superfansizhe-beep/tscircuit-stm32f302-board/circuits/stm32f302/REQUIREMENTS.md

# 需求清单 — STM32F302R8T6 考核板

> 来源：`~/Downloads/1(1).docx`（21 段，无图片、无隐藏内容，已逐字核对）
> 硬截止：**2026-10-13 18:00**　提交邮箱：`sorenlin21@gmail.com`
> 本文只讲"要做什么"，不讲"怎么做"。选型与实现见后续文档。

---

## 0. 题目原文（逐条转录）

```
1. 实现电压转换 12V 转 5V 转 3.3V（带电源指示灯）。
   12V 转 5V 使用 RY8411，5V 转 3.3V 使用 TLV75733PDBVR。
   要有开关方便测试，电源接口为 XT30。
2. 实现 STM32F302R8T6 最小系统，包括 8MHz 外部晶振、RESET 按键、BOOT 按键及 SWD
   下载调试接口等（可以不用低速晶振）。
3. 实现三路 UART，均使用 PH2.0 接口引出，包含 3.3V、GND、TX、RX。
4. 实现三路 I2C。一路连接 AT24C64D EEPROM，一路连接 TMP1075 温度传感器，一路使用
   PH2.0 接口引出。
5. 实现两路 SPI。一路连接 MCP23S17，扩展 16 路 GPIO，并使用 2×8、2.54mm 排针引出；
   另一路使用 PH2.0 1×6P 接口引出。
6. 实现一路 CAN 通信，使用 TCAN332 CAN 收发器，接口引出 CANH、CANL，使用 PH2.0
   接口引出。
7. 实现六路 PWM 输出，使用 3个1×6 排针，三排分别为 PWM、5V、GND
   （建议搜搜看pwm排针是怎么摆放的）
8. 实现三路 ADC 电压采样，分别采集 12V、5V、3.3V 电源电压。
9. 实现三路 GPIO 驱动 LED 指示灯。
10. 所有贴片电阻、电容统一采用 0603 或 0805封装，8MHz 晶振采用 3225 封装。
11. PCB 尺寸不超过 80mm×80mm，层数不超过 4 层。
```

> ⚠️ 第 7 条原文是「3个**1×6** 排针」。旧交接文档里写的「1×16」与原文不符，**以原文为准**。

---

## 1. 交付物与评分

### 交付物

| # | 交付物 | 形式 |
|---|---|---|
| D1 | 原理图截图 | 图片 |
| D2 | PCB 正面截图 | 图片 |
| D3 | PCB 反面截图 | 图片 |
| D4 | `.epro2` 工程文件 | 嘉立创 EDA 专业版格式 |

全部发到 `sorenlin21@gmail.com`。截止 **10-13 18:00**。

### 评分权重

| 项 | 占比 | 细分 |
|----|---|---|
| **原理图** | **60%** | 元件 40% + 电源 30% + 标注 20% + 布局 10% |
| **PCB** | **40%** | 布局 70% + 布线 30% |

> 出题人原话：「请优先保证！！原理图准确！！再开始布局PCB（会保证原理图质量，
> 我看到原理图错太多心情会不好）」
> **→ 施工顺序必须是：原理图做对做干净 → 才开始 PCB。**

### 红线

| 红线 | 后果 |
|---|---|
| **禁止使用嘉立创自动布线** | **0 分** |
| 禁止问学长学姐（除题目阅读理解外） | — |
| 可以适当使用 AI 工具 | 允许 |

---

## 2. 显式要求清单

### R1 — 电源转换（要求 1）

| # | 要求 | 备注 |
|---|---|---|
| R1.1 | 12V → 5V，**必须**用 RY8411 | 型号指定，不可换 |
| R1.2 | 5V → 3.3V，**必须**用 TLV75733PDBVR | 型号指定，不可换 |
| R1.3 | 带电源指示灯 | ⚠️ 数量未指定，见 §4-Q2 |
| R1.4 | 要有开关，方便测试 | ⚠️ 总开关还是分路，见 §4-Q3 |
| R1.5 | 电源接口为 XT30 | 公/母头未指定 |

### R2 — MCU 最小系统（要求 2）

| # | 要求 | 备注 |
|---|---|---|
| R2.1 | 主控 STM32F302R8T6 | ⚠️ 原厂无货，见 §4-Q1 |
| R2.2 | 8MHz 外部晶振（HSE） | 封装强制 3225（R10.3） |
| R2.3 | RESET 按键 | |
| R2.4 | BOOT 按键 | 即 BOOT0 选择 |
| R2.5 | SWD 下载调试接口 | ⚠️ 排针规格未指定，见 §4-Q5 |
| R2.6 | 「**等**」= 隐含必需项 | 见下方推导 |
| R2.7 | 可以不用低速晶振（LSE） | 即 32.768kHz 可不装 |

**R2.6「等」的推导**（最小系统跑起来所必需，题目没写但不能漏）：

- 全部 VDD / VSS 引脚 + 每对一颗 100nF 去耦
- VDDA / VSSA 滤波（1µF + 10nF）
- VREF+ 处理
- VCAP（若该型号有）接电容
- VBAT 处理
- BOOT0 下拉电阻（否则不能稳定从 Flash 启动）
- NRST 上拉 + 滤波电容
- 晶振负载电容（按晶振规格）
- 各路电源的储能/大容量电容

### R3 — 三路 UART（要求 3）

| # | 要求 |
|---|---|
| R3.1 | 共 **3** 路 |
| R3.2 | 每路用 **PH2.0** 接口引出 |
| R3.3 | 每路 **4 线**：3.3V、GND、TX、RX |

### R4 — 三路 I2C（要求 4）

| # | 要求 | 连接对象 |
|---|---|---|
| R4.1 | 第 1 路 | **AT24C64D** EEPROM |
| R4.2 | 第 2 路 | **TMP1075** 温度传感器 |
| R4.3 | 第 3 路 | **PH2.0** 接口引出 |

- 隐含：I2C 需要上拉电阻（阻值按总线速率与容性负载定）
- ⚠️ 硬件 I2C 资源可能不足 3 路，见 §4-Q4

### R5 — 两路 SPI（要求 5）

| # | 要求 | 细节 |
|---|---|---|
| R5.1 | SPI-A → **MCP23S17** | 扩展 **16 路 GPIO**，用 **2×8、2.54mm 排针**引出 |
| R5.2 | SPI-B | 用 **PH2.0 1×6P** 接口引出 |

- 隐含：MCP23S17 是 SPI 接口的 16 位 IO 扩展器，需要 CS、地址脚 A0/A1/A2、
  RESET、INT 的处理；2×8 = 16 脚正好对应 16 路 GPIO

### R6 — 一路 CAN（要求 6）

| # | 要求 |
|---|---|
| R6.1 | 使用 **TCAN332** CAN 收发器 |
| R6.2 | 接口引出 **CANH、CANL** |
| R6.3 | 使用 **PH2.0** 接口引出 |

- ⚠️ 终端电阻（120Ω）题目未提，见 §4-Q6

### R7 — 六路 PWM（要求 7）

| # | 要求 |
|---|---|
| R7.1 | 共 **6** 路 PWM 输出 |
| R7.2 | 使用 **3 个 1×6 排针** |
| R7.3 | 「三排分别为 PWM、5V、GND」 |

> ⚠️ **R7.3 是本清单歧义最大的一条**，出题人还专门提示「建议搜搜看pwm排针是怎么摆放的」，
> 说明他心里有一个标准摆法。两种读法见 §4-Q7，**开工前必须定死**。

### R8 — 三路 ADC 采样（要求 8）

| # | 要求 |
|---|---|
| R8.1 | 采集 **12V** 电源电压 |
| R8.2 | 采集 **5V** 电源电压 |
| R8.3 | 采集 **3.3V** 电源电压 |

- 隐含：12V/5V 超出 ADC 量程（3.3V），必须分压；分压比与功耗需权衡

### R9 — 三路 GPIO LED（要求 9）

| # | 要求 |
|---|---|
| R9.1 | **3** 路 GPIO |
| R9.2 | 驱动 **LED 指示灯** |

- 隐含：每路需限流电阻；LED 接法（灌电流/拉电流）影响固件极性

### R10 — 封装规范（要求 10）

| # | 要求 |
|---|---|
| R10.1 | **所有**贴片电阻统一 0603 或 0805 |
| R10.2 | **所有**贴片电容统一 0603 或 0805 |
| R10.3 | 8MHz 晶振采用 **3225** 封装 |

### R11 — 板子约束（要求 11）

| # | 要求 |
|---|---|
| R11.1 | PCB 尺寸 **≤ 80mm × 80mm** |
| R11.2 | 层数 **≤ 4 层** |

---

## 3. 模块划分

一个子电路一个文件，最后在 `main.tsx` 里拼装。

| 模块 | 文件 | 覆盖要求 | 主要器件 |
|---|---|---|---|
| **M1 电源** | `modules/01-power.tsx` | R1 | XT30、开关、RY8411、TLV75733PDBVR、电源指示灯、储能/去耦 |
| **M2 MCU 最小系统** | `modules/02-mcu.tsx` | R2 | STM32F302R8T6、8MHz 3225、RESET/BOOT 按键、SWD、全套去耦 |
| **M3 UART ×3** | `modules/03-uart.tsx` | R3 | 3× PH2.0 1×4 |
| **M4 I2C ×3** | `modules/04-i2c.tsx` | R4 | AT24C64D、TMP1075、PH2.0 1×4、上拉电阻 |
| **M5 SPI ×2** | `modules/05-spi.tsx` | R5 | MCP23S17、2×8 排针、PH2.0 1×6 |
| **M6 CAN** | `modules/06-can.tsx` | R6 | TCAN332、PH2.0、（终端电阻？） |
| **M7 PWM ×6** | `modules/07-pwm.tsx` | R7 | 3× 1×6 排针 |
| **M8 ADC 采样** | `modules/08-adc.tsx` | R8 | 分压电阻网络 ×3 |
| **M9 GPIO LED** | `modules/09-led.tsx` | R9 | LED ×3 + 限流电阻 ×3 |
| **M0 顶层拼装** | `main.tsx` | R10, R11, 全局 | 板框、丝印、电源网络分配 |

### 横切关注点（不属于任何单个模块）

- **电源网络分配**：`net.VIN_12V` / `net.+5V` / `net.+3V3` / `net.GND` 的统一定义与跨模块复用
- **全局去耦**：每个 IC 的电源脚就近去耦（在各自模块内实现，但需全局清点，防止漏接）
- **测试点**：ADC 与各路电源是否加测试点
- **丝印**：接口定义标注（PH2.0 各脚是什么、排针各脚是什么）

---

## 4. 决策记录（已全部拍板）

> 总原则（用户原话）：**「不用达到最完美答案，只要不错能过就行。」**
> 因此下列决策一律选「**不会因为选错而被扣分**」的那个，而不是「最优」的那个。

| # | 问题 | **决策** | 依据 |
|---|---|---|---|
| **Q1** | STM32F302R8T6 无货 | **照题面画 STM32F302R8T6（LQFP-64）**，不管现实库存 | 用户指示：「照着题面画，不用管现实问题」。题目钉死型号，改型号反而是错 |
| **Q2** | 电源指示灯几颗 | **3 颗**：12V、5V、3.3V 各一颗 | 「带电源指示灯」未指定数量；每路一颗可覆盖全部解读，**不会因为少装被判漏** |
| **Q3** | 开关形式 | **12V 输入总开关**（SPDT 拨动开关） | 「要有开关方便测试」——总开关是最直接、最不会被挑刺的实现 |
| **Q4** | 硬件 I2C 够不够 3 路 | ✅ **已查明：够。有 I2C1 / I2C2 / I2C3 三路硬件 I2C** | ST 官方 CMSIS 头 `stm32f302x8.h`（见 §4.1）。**不需要软件模拟** |
| **Q5** | SWD 接口规格 | **2×5、2.54mm 排针**（ARM 标准 10 脚） | 最通用、最好焊、评审一眼认得 |
| **Q6** | CAN 终端电阻 | **板载 120Ω 一颗** | CAN 总线的标准要求，装了是正确，不装才是缺陷 |
| **Q7** | PWM 排针摆法 | **三排平行紧贴的「舵机轨」**（见 §4.2） | 同时满足题面字面要求 + 题面提示的行业惯例 |
| **Q8** | ADC 分压比 | 12V/5V 分压到 ADC 满量程**留余量** | 避免超量程；「不错即可」 |
| **Q9** | 是否装 LSE | **不装** | 题目明说「可以不用低速晶振」 |
| **Q10** | 板层数 | **2 层** | 上限是 4 层，2 层已足够且**更容易被评审看懂**；布线也更容易做干净 |

### 4.1 Q4 的证据（一手权威源）

ST 官方 CMSIS 设备头文件 `stm32f302x8.h`（覆盖 STM32F302R8T6）中定义的完整外设清单：

```
I2C1_BASE  I2C2_BASE  I2C3_BASE          ← 三路硬件 I2C，正好满足要求 4
SPI2_BASE  SPI3_BASE                     ← 两路 SPI（注意：没有 SPI1）
USART1_BASE USART2_BASE USART3_BASE      ← 三路 UART，正好满足要求 3
ADC1_BASE                                ← 只有 ADC1（多通道）
CAN_BASE
TIM1 TIM2 TIM6 TIM15 TIM16 TIM17         ← 无 TIM3 / TIM4
GPIOA GPIOB GPIOC GPIOD GPIOF            ← 注意：没有 GPIOE
```

**来源**：`https://raw.githubusercontent.com/STMicroelectronics/cmsis-device-f3/master/Include/stm32f302x8.h`
（st.com 本站直连与代理均被 WAF 拦，HTTP 567；GitHub 上的 ST 官方仓库可达。）

**对本设计的三个直接影响**：

1. 要求 4 的三路 I2C → 直接用 I2C1/I2C2/I2C3，**无需求助软件模拟**。
2. 要求 5 的两路 SPI → 只能落在 **SPI2 与 SPI3**（该型号没有 SPI1），引脚分配时不要去找 SPI1。
3. 要求 7 的六路 PWM → 可用通道富裕：TIM1(4) + TIM2(4) + TIM15(2) + TIM16(1) + TIM17(1)。

### 4.2 Q7 的答案：三排平行紧贴的「舵机轨」

**做法**：3 个 1×6 排针**平行、紧贴、行距 2.54mm** 摆放：

```
        列1    列2    列3    列4    列5    列6
第1排   PWM1   PWM2   PWM3   PWM4   PWM5   PWM6     ← 整排都是 PWM 信号
第2排   +5V    +5V    +5V    +5V    +5V    +5V      ← 整排都是 5V
第3排   GND    GND    GND    GND    GND    GND      ← 整排都是 GND
```

**为什么这个答案是「能过」的**：

| 判据 | 是否满足 |
|---|---|
| 「使用 **3个1×6 排针**」 | ✅ 字面满足：确实是三个独立的 1×6 排针 |
| 「**三排分别为 PWM、5V、GND**」 | ✅ 字面满足：第 1 排全是 PWM、第 2 排全是 5V、第 3 排全是 GND |
| 题面提示「建议搜搜看 pwm 排针是怎么摆放的」 | ✅ 每**列**（跨三排）正好构成一个标准 3 脚舵机/PWM 接口，脚序 **信号 → 电源 → 地**，与题面给出的顺序一字不差。这是行业惯例摆法 |

**关键点**：这个解法让「按信号分排」（字面）和「按通道分组」（惯例）**同时成立** ——
三排各自是同一种信号（满足字面），而竖着看每一列就是一个完整通道（满足惯例）。
不需要在两者之间二选一。

**来源参考**：舵机标准 3 线定义为 信号 / 电源 / 地
（[01Studio 舵机文档](https://wiki.01studio.cc/docs/canmv_k230/sensor_module/servo/)、
[Waveshare Servo Driver HAT 手册](https://www.waveshare.net/w/upload/e/e3/Servo_Driver_HAT_User_Manual_CN.pdf)、
[NXP HoverGames Servorail](https://nxp.gitbook.io/hovergames/rddrone-fmuk66/connectors/servorail)）。

---

### 4.3 原始待澄清项（存档，供追溯）

按「不解决就会做错」的严重性排序。

| # | 问题 | 影响 | 备选 |
|---|---|---|---|
| **Q1** | **STM32F302R8T6 全系无货**（C504601 及 R8T6TR 库存均为 0） | 物料不可得 | 换 **STM32F302RCT6**（同 LQFP-64 封装、引脚兼容、Flash 更大、库存 4427）。若严格按题面型号，则只能按 R8T6 画板、物料自备 |
| **Q2** | **R1.3「带电源指示灯」几颗？** | 元件数与丝印 | (a) 一颗总电源灯　(b) 12V/5V/3.3V 各一颗　(c) 5V/3.3V 各一颗 |
| **Q3** | **R1.4「开关方便测试」是哪种开关？** | 电路拓扑 | (a) 12V 输入总开关　(b) 每路输出一个测试开关　(c) 总开关 + 跳线帽 |
| **Q4** | **STM32F302R8T6 硬件 I2C 是否够 3 路？** | 引脚分配 | 若只有 I2C1/I2C2，第 3 路需 GPIO 软件模拟。正在核实 |
| **Q5** | **SWD 接口规格？** | 连接器选型 | (a) 2×5 1.27mm（ARM 标准）　(b) 2×5 2.54mm　(c) 1×4 2.54mm |
| **Q6** | **CAN 要不要板载 120Ω 终端电阻？** | 电路正确性 | (a) 固定焊一颗　(b) 跳线/焊接跳线可选　(c) 不装 |
| **Q7** | **R7「三排分别为 PWM、5V、GND」到底怎么摆？** | 排针定义 | 见下方专项分析 |
| **Q8** | **ADC 分压比与输入阻抗？** | 采样精度 | 12V 分压比需保证 3.3V 满量程留余量 |
| **Q9** | **是否需要 LSE（32.768kHz）？** | 元件数 | 题目明说「可以不用」→ 建议不装 |
| **Q10** | **PCB 层数用 2 层还是 4 层？** | 布线难度 | 题目上限 4 层；2 层更易手工/评审，4 层更好布线 |

### Q7 专项分析（PWM 排针摆法）

题面「3个1×6 排针，三排分别为 PWM、5V、GND」，两种读法：

- **读法 A —— 按信号分排**：3 个排针，一个全是 6 路 PWM 信号、一个全是 6 个 5V、一个全是 6 个 GND。
  用杜邦线跨接使用。
- **读法 B —— 按通道分组**：每个 1×6 排针装 2 路完整通道，脚序 `PWM,5V,GND,PWM,5V,GND`。
  3 个排针 = 6 路。这是舵机/风扇类接口的常见摆法，也给每路就地供电与地回路。

题面特意提示「建议搜搜看pwm排针是怎么摆放的」，出题人大概率指的是**读法 B**
（这是行业里 PWM 排针的惯用摆法），但需要调研确认，必要时向出题人提问（题目允许问阅读理解问题）。

---

## 5. 硬约束速查（不可违背）

| 约束 | 内容 |
|---|---|
| 型号钉死 | RY8411、TLV75733PDBVR、STM32F302R8T6、AT24C64D、TMP1075、MCP23S17、TCAN332 |
| 封装钉死 | 贴片阻容 0603 或 0805；8MHz 晶振 3225 |
| 接口钉死 | XT30 电源；UART/I2C/CAN 用 PH2.0；SPI-A 用 2×8 2.54mm 排针；SPI-B 用 PH2.0 1×6P；PWM 用 3× 1×6 排针 |
| 板子钉死 | ≤80×80mm，≤4 层 |
| 流程钉死 | 先原理图后 PCB；禁止嘉立创自动布线 |
| 时间钉死 | 10-13 18:00 |
