superfansizhe-beep/tscircuit-stm32f302-board/circuits/stm32f302/REFDES.md

# 位号分配表 — 全板唯一

**为什么必须提前定**：位号（R1 / C1 / U1 …）在整块板上必须**全局唯一**。
如果每个模块各自从 R1 开始编，9 个模块会撞出 9 个 R1 —— 而 tscircuit **不会报错**，
只会生成一堆重名元件，PCB 丝印、BOM、装配图全乱。这是必须在放器件之前钉死的。

---

## 分配总表

| 模块 | 页 | 电阻 | 电容 | 其它元件 |
|---|----|---|---|---|
| **01 电源** | 电源 | `R1–R9` | `C1–C9` | `U1` `U2` `L1` `SW1` `J1` `D1–D3` |
| **02 最小系统** | 最小系统 | `R10–R19` | `C10–C29` | `U3` `Y1` `SW2` `SW3` `J11` |
| **03 串口** | UART | — | — | `J2` `J3` `J4` |
| **04 I2C** | I2C | `R20–R25` | `C30–C31` | `U4` `U5` `J5` |
| **05 SPI** | SPI | `R26–R27` | `C32–C33` | `U6` `J6` `J12` |
| **06 CAN** | CAN | `R28–R29` | `C34` | `U7` `J7` |
| **07 PWM** | PWM | — | — | `J8` `J9` `J10` |
| **08 ADC 采样** | ADC 采样 | `R30–R35` | `C35–C37` | — |
| **09 指示灯** | 指示灯 | `R36–R38` | — | `LED1–LED3` |

**留白**：每段都留了余量。实装时若超出，**顺延到下一个未被占用的号**，
不要插进别的模块的段里（那会破坏"按模块可读"的好处）。

---

## 命名约定

| 前缀 | 含义 | 示例 |
|---|---|---|
| `U` | 集成电路 | `U1` RY8411 |
| `R` | 电阻 | `R1` 100k |
| `C` | 电容 | `C1` 22µF |
| `L` | 电感 | `L1` 4.7µH |
| `D` | **电源指示灯**（电源页） | `D1` 12V 红 |
| `LED` | **GPIO 指示灯**（指示灯页） | `LED1` PC6 绿 |
| `Y` | 晶振 | `Y1` 8MHz |
| `FB` | 磁珠 | `FB1` VDDA 隔离 |
| `SW` | 开关 / 按键 | `SW1` 拨动开关、`SW2` RESET |
| `J` | 连接器 / 排针 | `J1` XT30、`J11` SWD |

> ⚠️ **`D` 与 `LED` 是两套不同的东西**，不要混：
> `D1–D3` 是电源页的三颗电源指示灯（12V / 5V / 3.3V）；
> `LED1–LED3` 是要求 9 的三颗 GPIO 驱动指示灯。
> 分开命名是为了让"要求 1 的指示灯"和"要求 9 的指示灯"在 BOM 和丝印上一眼可辨。

---

## 各模块详细占用

### 01 电源页

| 位号 | 器件 | 值 / 型号 | 封装 |
|---|---|---|---|
| `J1` | XT30 电源座 | XT30UPB-M | 插件 |
| `SW1` | 电源开关 | SS-12F44-G5 | 插件 SPDT |
| `U1` | 降压 IC | RY8411 | SOT-23-6 |
| `L1` | 功率电感 | 4.7µH | 4×4mm |
| `U2` | LDO | TLV75733PDBVR | SOT-23-5 |
| `C1` | 12V 输入储能 | 22µF | 0805 |
| `C2` | 12V 输入高频去耦 | 100nF | 0603 |
| `C3` | 自举电容（BS–SW） | 100nF | 0603 |
| `R4` | FB 上分压 | 100k | 0603 |
| `R5` | FB 下分压 | 19.1k | 0603 |
| `C4` | 5V 输出储能 | 22µF | 0805 |
| `C5` | 5V 输出高频 | 100nF | 0603 |
| `C6` | 3.3V 输入电容 | 1µF | 0603 |
| `C7` | 3.3V 输出电容 | 1µF | 0603 |
| `R1` | 12V 指示灯限流 | 4.7k | 0603 |
| `D1` | 12V 指示灯 | 红 | 0603 |
| `R2` | 5V 指示灯限流 | 1k | 0603 |
| `D2` | 5V 指示灯 | 绿 | 0603 |
| `R3` | 3.3V 指示灯限流 | 330Ω | 0603 |
| `D3` | 3.3V 指示灯 | 蓝 | 0603 |

### 02 最小系统页

| 位号 | 器件 | 值 / 型号 | 封装 |
|---|---|---|---|
| `U3` | 主控 | STM32F302R8T6 | LQFP-64 |
| `Y1` | HSE 晶振 | 8MHz 无源 | SMD3225-4P |
| `SW2` | RESET 按键 | TS-1187A | SMD-4P |
| `SW3` | BOOT 按键 | TS-1187A | SMD-4P |
| `J11` | SWD 调试口 | 2×5 2.54mm | 插件 |
| `FB1` | VDDA 隔离磁珠 | BLM18AG601SN1D | C19330 | 0603 |
| `C10–C13` | VDD 去耦 | 100nF ×4 | 0603 |
| `C14` | VDD 总储能 | 4.7µF | 0603 |
| `C15` | VDDA 滤波 | 1µF | 0603 |
| `C16` | VDDA 高频 | 10nF | 0603 |
| `C17` | VBAT 去耦 | 100nF | 0603 |
| `C18–C19` | 晶振负载电容 | 15pF ×2 | 0603 |
| `R10` | NRST 上拉 | 10k | 0603 |
| `C20` | NRST 滤波 | 100nF | 0603 |
| `R11` | BOOT0 下拉 | 10k | 0603 |
| `R12` | BOOT1 下拉 | 10k | 0603 |

（其余位号留白给上电时序、测试点等）
