superfansizhe-beep/tscircuit-stm32f302-board/out/stm32f302/deliverables/01-原理图/00-九页总图.png

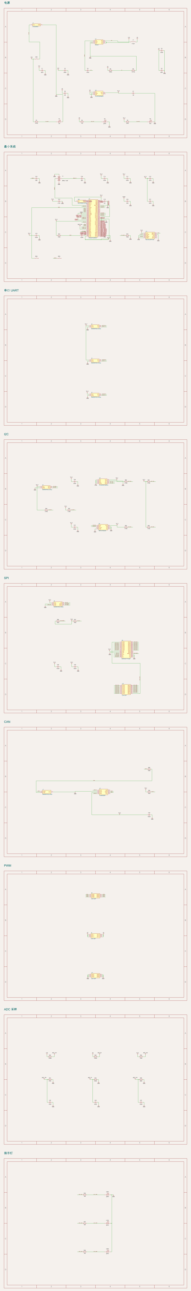
out/stm32f302/deliverables/01-原理图/00-九页总图.png
