superfansizhe-beep/tscircuit-stm32f302-board/out/stm32f302/deliverables/01-原理图/03-串口页.png

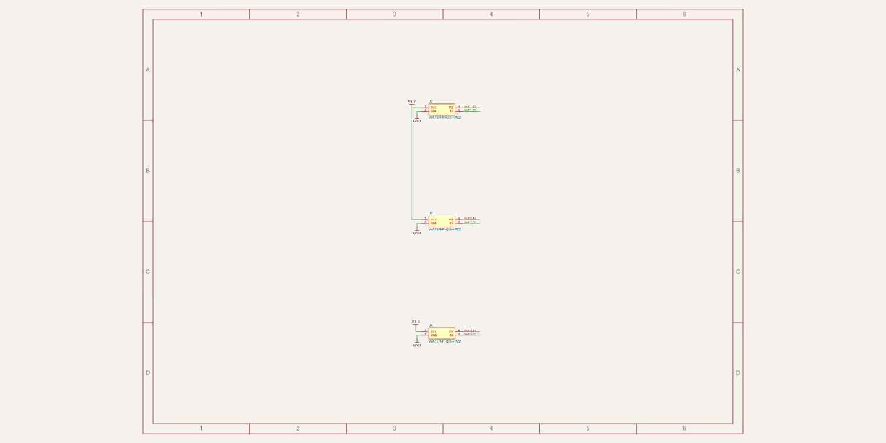
out/stm32f302/deliverables/01-原理图/03-串口页.png
