superfansizhe-beep/tscircuit-stm32f302-board/out/stm32f302/deliverables/01-原理图/09-指示灯页.png

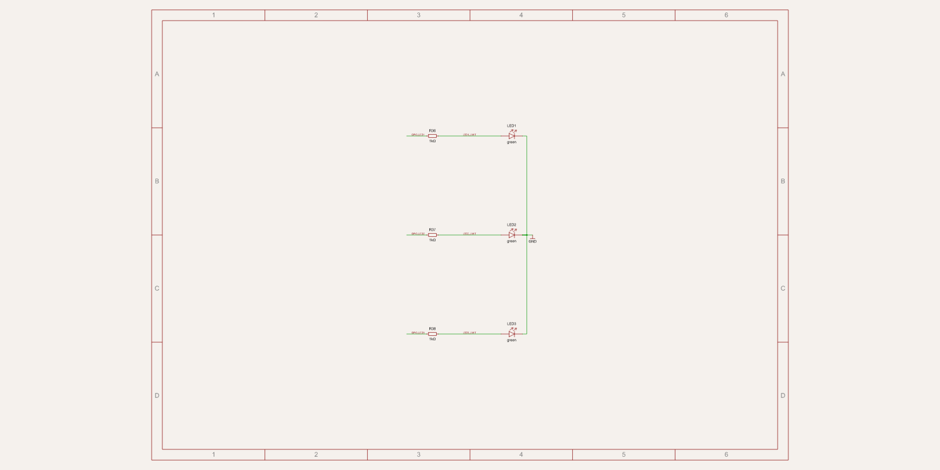
out/stm32f302/deliverables/01-原理图/09-指示灯页.png
