superfansizhe-beep/tscircuit-stm32f302-board/out/stm32f302/deliverables/02-PCB/PCB-底层.png

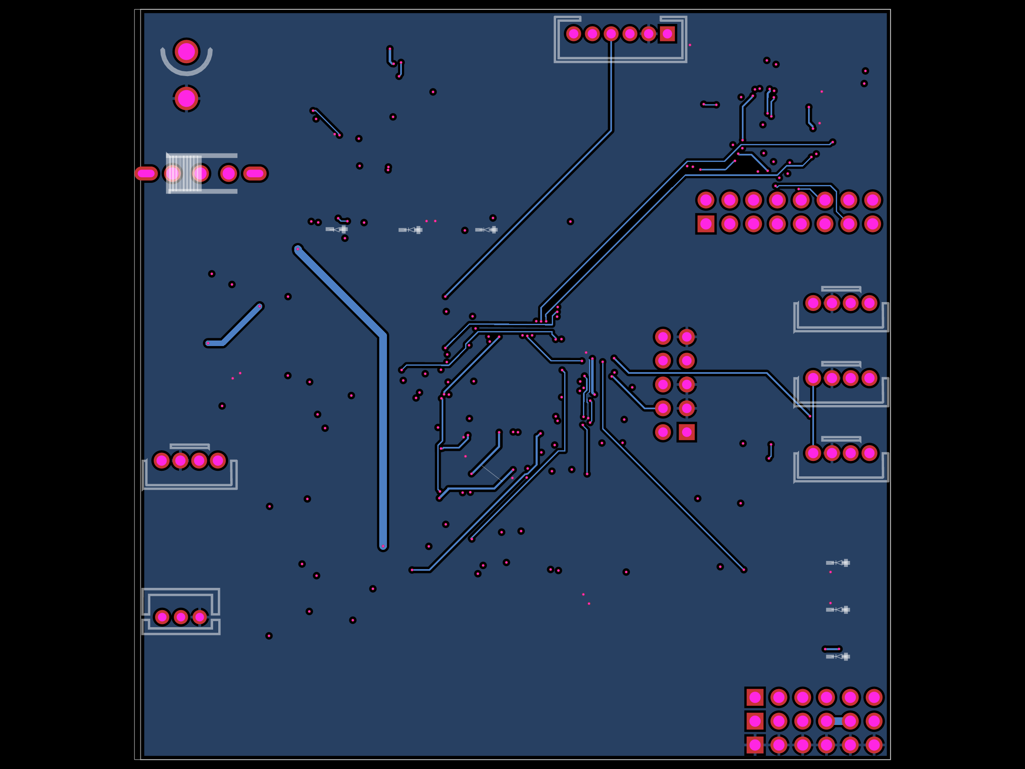
out/stm32f302/deliverables/02-PCB/PCB-底层.png
