superfansizhe-beep/tscircuit-stm32f302-board/circuits/stm32f302/BOM-AUTO.md

# BOM（自动生成）— STM32F302R8T6 考核板

> **本文件由 `scripts/gen-bom.py` 从 circuit-json 自动生成，请勿手改。**
> 元件/参数/C 编号/厂商型号取自 `out/stm32f302/main.json`（tsci export 产物）；
> 封装规格由嘉立创官方接口按 C 编号查得（缓存于 `out/stm32f302/jlc-packages.json`）。
> 手写 BOM 一定会跟设计脱节，所以这张表必须从实际产物反推。

**元件总数：84**　按料号合并后 **37 种**

---

## 1. 下单汇总（按料号合并）

| # | C 编号 | 厂商型号 | 封装 | 参数 | 数量 | 位号 |
|---:|---|---|---|---|:---:|---|
| 1 | `C14663` | CC0603KRX7R9BB104 | 0603 | 100nF | 17 | C2 C3 C5 C10 C11 C12 C13 C17 C20 C30 C31 C32 C33 C34 C35 … |
| 2 | `C23162` | 0603WAF4701T5E | 0603 | 4.7kΩ | 7 | R1 R20 R21 R22 R23 R24 R25 |
| 3 | `C25804` | 0603WAF1002T5E | 0603 | 10kΩ | 7 | R10 R11 R12 R26 R27 R29 R34 |
| 4 | `C21190` | 0603WAF1001T5E | 0603 | 1kΩ | 4 | R2 R36 R37 R38 |
| 5 | `C25803` | 0603WAF1003T5E | 0603 | 100kΩ | 4 | R4 R30 R32 R33 |
| 6 | `C5359601` | WAFER-PH2.0-4PZZ | Plugin,P=2mm | — | 4 | J2 J3 J4 J5 |
| 7 | `C84267` | NCD0603G1 | 0603 | green | 4 | D2 LED1 LED2 LED3 |
| 8 | `C15849` | CL10A105KB8NNNC | 0603 | 1uF | 3 | C6 C7 C15 |
| 9 | `C37208` | 2.54-1x6P | Plugin,P=2.54mm | — | 3 | J10 J8 J9 |
| 10 | `C107034` | CC0603JRNPO9BN120 | 0603 | 12pF | 2 | C18 C19 |
| 11 | `C318884` | TS-1187A-B-A-B | SMD-4P,5.1x5.1mm | — | 2 | SW2 SW3 |
| 12 | `C45783` | CL21A226MAQNNNE | 0805 | 22uF | 2 | C1 C4 |
| 13 | `C128577` | MCP23S17T-E/SS | SSOP-28-208mil | — | 1 | U6 |
| 14 | `C136718` | SS-12F44-G5 | Plugin | — | 1 | SW1 |
| 15 | `C1589` | CL10B103KB8NNNC | 0603 | 10nF | 1 | C16 |
| 16 | `C19330` | BLM18AG601SN1D | 0603 | — | 1 | FB1 |
| 17 | `C19666` | CL10A475KO8NNNC | 0603 | 4.7uF | 1 | C14 |
| 18 | `C22787` | 0603WAF1200T5E | 0603 | 120Ω | 1 | R28 |
| 19 | `C2286` | KT-0603R | 0603 | red | 1 | D1 |
| 20 | `C22897` | 0603WAF1912T5E | 0603 | 19.1kΩ | 1 | R5 |
| 21 | `C22967` | 0603WAF2702T5E | 0603 | 27kΩ | 1 | R31 |
| 22 | `C23138` | 0603WAF3300T5E | 0603 | 330Ω | 1 | R3 |
| 23 | `C2864807` | TMP1075DGKR | VSSOP-8 | — | 1 | U5 |
| 24 | `C2935411` | RY8411 | SOT-23-6 | — | 1 | U1 |
| 25 | `C354583` | CKCSA4020-4.7uH/M | SMD,4x4mm | 4.7µH | 1 | L1 |
| 26 | `C400090` | TAXM8M4RDBCCT2T | SMD3225-4P | 8MHz | 1 | Y1 |
| 27 | `C4216` | 0603WAF3302T5E | 0603 | 33kΩ | 1 | R35 |
| 28 | `C42431818` | PZ2.54-2X5P-H25 | Plugin,P=2.54mm | — | 1 | J11 |
| 29 | `C428721` | XT30UPB-M | 插件通孔（XT30 板端公头） | — | 1 | J1 |
| 30 | `C485517` | TLV75733PDBVR | SOT-23-5 | — | 1 | U2 |
| 31 | `C504601` | STM32F302R8T6 | LQFP-64(10x10) | — | 1 | U3 |
| 32 | `C5359600` | WAFER-PH2.0-3PZZ | Plugin,P=2mm | — | 1 | J7 |
| 33 | `C5359603` | WAFER-PH2.0-6PZZ | Plugin,P=2mm | — | 1 | J6 |
| 34 | `C6487` | AT24C64D-SSHM-T | SOIC-8 | — | 1 | U4 |
| 35 | `C68234` | 2.54-2*8P | Plugin,P=2.54mm | — | 1 | J12 |
| 36 | `C73651` | TCAN332DR | SOIC-8 | — | 1 | U7 |
| 37 | `C84266` | NCD0603B1 | 0603 | blue | 1 | D3 |

---

## 2. 逐元件明细（按页）

### PWR 页

| 位号 | 类型 | 参数 | 封装 | C 编号 | 厂商型号 | 焊盘 |
|---|---|---|---|---|---|:---:|
| **C1** | capacitor | 22uF | 0805 | `C45783` | CL21A226MAQNNNE | 2 |
| **C2** | capacitor | 100nF | 0603 | `C14663` | CC0603KRX7R9BB104 | 2 |
| **C3** | capacitor | 100nF | 0603 | `C14663` | CC0603KRX7R9BB104 | 2 |
| **C4** | capacitor | 22uF | 0805 | `C45783` | CL21A226MAQNNNE | 2 |
| **C5** | capacitor | 100nF | 0603 | `C14663` | CC0603KRX7R9BB104 | 2 |
| **C6** | capacitor | 1uF | 0603 | `C15849` | CL10A105KB8NNNC | 2 |
| **C7** | capacitor | 1uF | 0603 | `C15849` | CL10A105KB8NNNC | 2 |
| **D1** | led | red | 0603 | `C2286` | KT-0603R | 2 |
| **D2** | led | green | 0603 | `C84267` | NCD0603G1 | 2 |
| **D3** | led | blue | 0603 | `C84266` | NCD0603B1 | 2 |
| **J1** | connector | — | 插件通孔（XT30 板端公头） | `C428721` | XT30UPB-M | 2 |
| **L1** | inductor | 4.7µH | SMD,4x4mm | `C354583` | CKCSA4020-4.7uH/M | 2 |
| **R1** | resistor | 4.7kΩ | 0603 | `C23162` | 0603WAF4701T5E | 2 |
| **R2** | resistor | 1kΩ | 0603 | `C21190` | 0603WAF1001T5E | 2 |
| **R3** | resistor | 330Ω | 0603 | `C23138` | 0603WAF3300T5E | 2 |
| **R4** | resistor | 100kΩ | 0603 | `C25803` | 0603WAF1003T5E | 2 |
| **R5** | resistor | 19.1kΩ | 0603 | `C22897` | 0603WAF1912T5E | 2 |
| **SW1** | switch | — | Plugin | `C136718` | SS-12F44-G5 | 5 |
| **U1** | chip | — | SOT-23-6 | `C2935411` | RY8411 | 6 |
| **U2** | chip | — | SOT-23-5 | `C485517` | TLV75733PDBVR | 5 |

### MCU 页

| 位号 | 类型 | 参数 | 封装 | C 编号 | 厂商型号 | 焊盘 |
|---|---|---|---|---|---|:---:|
| **C10** | capacitor | 100nF | 0603 | `C14663` | CC0603KRX7R9BB104 | 2 |
| **C11** | capacitor | 100nF | 0603 | `C14663` | CC0603KRX7R9BB104 | 2 |
| **C12** | capacitor | 100nF | 0603 | `C14663` | CC0603KRX7R9BB104 | 2 |
| **C13** | capacitor | 100nF | 0603 | `C14663` | CC0603KRX7R9BB104 | 2 |
| **C14** | capacitor | 4.7uF | 0603 | `C19666` | CL10A475KO8NNNC | 2 |
| **C15** | capacitor | 1uF | 0603 | `C15849` | CL10A105KB8NNNC | 2 |
| **C16** | capacitor | 10nF | 0603 | `C1589` | CL10B103KB8NNNC | 2 |
| **C17** | capacitor | 100nF | 0603 | `C14663` | CC0603KRX7R9BB104 | 2 |
| **C18** | capacitor | 12pF | 0603 | `C107034` | CC0603JRNPO9BN120 | 2 |
| **C19** | capacitor | 12pF | 0603 | `C107034` | CC0603JRNPO9BN120 | 2 |
| **C20** | capacitor | 100nF | 0603 | `C14663` | CC0603KRX7R9BB104 | 2 |
| **FB1** | chip | — | 0603 | `C19330` | BLM18AG601SN1D | 2 |
| **J11** | connector | — | Plugin,P=2.54mm | `C42431818` | PZ2.54-2X5P-H25 | 10 |
| **R10** | resistor | 10kΩ | 0603 | `C25804` | 0603WAF1002T5E | 2 |
| **R11** | resistor | 10kΩ | 0603 | `C25804` | 0603WAF1002T5E | 2 |
| **R12** | resistor | 10kΩ | 0603 | `C25804` | 0603WAF1002T5E | 2 |
| **SW2** | switch | — | SMD-4P,5.1x5.1mm | `C318884` | TS-1187A-B-A-B | 4 |
| **SW3** | switch | — | SMD-4P,5.1x5.1mm | `C318884` | TS-1187A-B-A-B | 4 |
| **U3** | chip | — | LQFP-64(10x10) | `C504601` | STM32F302R8T6 | 64 |
| **Y1** | crystal | 8MHz | SMD3225-4P | `C400090` | TAXM8M4RDBCCT2T | 4 |

### UART 页

| 位号 | 类型 | 参数 | 封装 | C 编号 | 厂商型号 | 焊盘 |
|---|---|---|---|---|---|:---:|
| **J2** | connector | — | Plugin,P=2mm | `C5359601` | WAFER-PH2.0-4PZZ | 4 |
| **J3** | connector | — | Plugin,P=2mm | `C5359601` | WAFER-PH2.0-4PZZ | 4 |
| **J4** | connector | — | Plugin,P=2mm | `C5359601` | WAFER-PH2.0-4PZZ | 4 |

### I2C 页

| 位号 | 类型 | 参数 | 封装 | C 编号 | 厂商型号 | 焊盘 |
|---|---|---|---|---|---|:---:|
| **C30** | capacitor | 100nF | 0603 | `C14663` | CC0603KRX7R9BB104 | 2 |
| **C31** | capacitor | 100nF | 0603 | `C14663` | CC0603KRX7R9BB104 | 2 |
| **J5** | connector | — | Plugin,P=2mm | `C5359601` | WAFER-PH2.0-4PZZ | 4 |
| **R20** | resistor | 4.7kΩ | 0603 | `C23162` | 0603WAF4701T5E | 2 |
| **R21** | resistor | 4.7kΩ | 0603 | `C23162` | 0603WAF4701T5E | 2 |
| **R22** | resistor | 4.7kΩ | 0603 | `C23162` | 0603WAF4701T5E | 2 |
| **R23** | resistor | 4.7kΩ | 0603 | `C23162` | 0603WAF4701T5E | 2 |
| **R24** | resistor | 4.7kΩ | 0603 | `C23162` | 0603WAF4701T5E | 2 |
| **R25** | resistor | 4.7kΩ | 0603 | `C23162` | 0603WAF4701T5E | 2 |
| **U4** | chip | — | SOIC-8 | `C6487` | AT24C64D-SSHM-T | 8 |
| **U5** | chip | — | VSSOP-8 | `C2864807` | TMP1075DGKR | 8 |

### SPI 页

| 位号 | 类型 | 参数 | 封装 | C 编号 | 厂商型号 | 焊盘 |
|---|---|---|---|---|---|:---:|
| **C32** | capacitor | 100nF | 0603 | `C14663` | CC0603KRX7R9BB104 | 2 |
| **C33** | capacitor | 100nF | 0603 | `C14663` | CC0603KRX7R9BB104 | 2 |
| **J12** | connector | — | Plugin,P=2.54mm | `C68234` | 2.54-2*8P | 16 |
| **J6** | connector | — | Plugin,P=2mm | `C5359603` | WAFER-PH2.0-6PZZ | 6 |
| **R26** | resistor | 10kΩ | 0603 | `C25804` | 0603WAF1002T5E | 2 |
| **R27** | resistor | 10kΩ | 0603 | `C25804` | 0603WAF1002T5E | 2 |
| **U6** | chip | — | SSOP-28-208mil | `C128577` | MCP23S17T-E/SS | 28 |

### CAN 页

| 位号 | 类型 | 参数 | 封装 | C 编号 | 厂商型号 | 焊盘 |
|---|---|---|---|---|---|:---:|
| **C34** | capacitor | 100nF | 0603 | `C14663` | CC0603KRX7R9BB104 | 2 |
| **J7** | connector | — | Plugin,P=2mm | `C5359600` | WAFER-PH2.0-3PZZ | 3 |
| **R28** | resistor | 120Ω | 0603 | `C22787` | 0603WAF1200T5E | 2 |
| **R29** | resistor | 10kΩ | 0603 | `C25804` | 0603WAF1002T5E | 2 |
| **U7** | chip | — | SOIC-8 | `C73651` | TCAN332DR | 8 |

### PWM 页

| 位号 | 类型 | 参数 | 封装 | C 编号 | 厂商型号 | 焊盘 |
|---|---|---|---|---|---|:---:|
| **J10** | connector | — | Plugin,P=2.54mm | `C37208` | 2.54-1x6P | 6 |
| **J8** | connector | — | Plugin,P=2.54mm | `C37208` | 2.54-1x6P | 6 |
| **J9** | connector | — | Plugin,P=2.54mm | `C37208` | 2.54-1x6P | 6 |

### ADC 页

| 位号 | 类型 | 参数 | 封装 | C 编号 | 厂商型号 | 焊盘 |
|---|---|---|---|---|---|:---:|
| **C35** | capacitor | 100nF | 0603 | `C14663` | CC0603KRX7R9BB104 | 2 |
| **C36** | capacitor | 100nF | 0603 | `C14663` | CC0603KRX7R9BB104 | 2 |
| **C37** | capacitor | 100nF | 0603 | `C14663` | CC0603KRX7R9BB104 | 2 |
| **R30** | resistor | 100kΩ | 0603 | `C25803` | 0603WAF1003T5E | 2 |
| **R31** | resistor | 27kΩ | 0603 | `C22967` | 0603WAF2702T5E | 2 |
| **R32** | resistor | 100kΩ | 0603 | `C25803` | 0603WAF1003T5E | 2 |
| **R33** | resistor | 100kΩ | 0603 | `C25803` | 0603WAF1003T5E | 2 |
| **R34** | resistor | 10kΩ | 0603 | `C25804` | 0603WAF1002T5E | 2 |
| **R35** | resistor | 33kΩ | 0603 | `C4216` | 0603WAF3302T5E | 2 |

### LED 页

| 位号 | 类型 | 参数 | 封装 | C 编号 | 厂商型号 | 焊盘 |
|---|---|---|---|---|---|:---:|
| **LED1** | led | green | 0603 | `C84267` | NCD0603G1 | 2 |
| **LED2** | led | green | 0603 | `C84267` | NCD0603G1 | 2 |
| **LED3** | led | green | 0603 | `C84267` | NCD0603G1 | 2 |
| **R36** | resistor | 1kΩ | 0603 | `C21190` | 0603WAF1001T5E | 2 |
| **R37** | resistor | 1kΩ | 0603 | `C21190` | 0603WAF1001T5E | 2 |
| **R38** | resistor | 1kΩ | 0603 | `C21190` | 0603WAF1001T5E | 2 |

---

## 3. 完整性自检

| 检查项 | 结果 |
|---|---|
| 每个元件都有电参数 | ✅ |
| 每个元件都有 C 编号 | ✅ |
| 每个元件都有厂商型号 | ✅ |
| 每个元件封装都生效（焊盘 > 0） | ✅ |

> **关于「封装」这一列**：tscircuit 不把封装存成字符串字段，而是
> 直接把 `footprint=` 解析成**真实焊盘几何**。所以「封装填了吗」的
> 判定标准是**焊盘数 > 0**，而不是某个字段非空。最后一列就是这个证据。
