superfansizhe-beep/tscircuit-stm32f302-board/circuits/stm32f302/BOM.md

# 器件清单 BOM（选型说明）— STM32F302R8T6 考核板

> ⚠️ **要看实际用量与位号，请看 [`BOM-AUTO.md`](./BOM-AUTO.md)** ——
> 那份是 `scripts/gen-bom.py` 从 circuit-json **自动生成**的，与设计永不脱节。
> 本文讲的是**选型依据**：为什么选这颗、淘汰了哪些、踩过什么坑。

> **封装策略**：全部走 `jlcpcb:Cxxxx`（嘉立创/EasyEDA 真实封装），**不自绘库、不手写焊盘**。
> **结论先说**：23 种器件的封装**库里全部都有**，焊盘数与引脚数逐一核对无误，**没有一个需要自己画库**。

---

## 1. 有源器件（IC）

| 位号 | 型号 | 封装 | C 编号 | 用途 | 数量 |
|---|---|---|---|---|:---:|
| **U1** | RY8411 | SOT-23-6 | `C2935411` | 12V→5V 同步降压（要求 1） | 1 |
| **U2** | TLV75733PDBVR | SOT-23-5 | `C485517` | 5V→3.3V LDO（要求 1） | 1 |
| **U3** | STM32F302R8T6 | LQFP-64 (10×10mm) | `C504601` | 主控（要求 2） | 1 |
| **U4** | AT24C64D-SSHM-T | SOIC-8 (150mil) | `C6487` | 64Kb I2C EEPROM（要求 4） | 1 |
| **U5** | TMP1075DGKR | VSSOP-8 | `C2864807` | I2C 温度传感器（要求 4） | 1 |
| **U6** | MCP23S17T-E/SS | SSOP-28 (208mil) | `C128577` | SPI 转 16 路 GPIO（要求 5） | 1 |
| **U7** | TCAN332DR | SOIC-8 | `C73651` | CAN 收发器（要求 6，**3.3V 器件**） | 1 |

> ⚠️ **U3 说明**：按用户指示**照题面画 STM32F302R8T6**。该型号在嘉立创 SMT 库当前库存为 0
> （`C504601` 与 `C2055019` 均为 0），但**封装照画、不改型号**。
> 同封装可替代料：`C133230` STM32F302RCT6（LQFP-64，引脚兼容）。

---

## 2. 电感与晶振

| 位号 | 型号 | 封装 | C 编号 | 关键参数 | 数量 |
|---|---|---|---|---|:---:|
| **L1** | CKCSA4020-4.7µH/M | SMD 4×4mm | `C354583` | 4.7µH，**Irms 2.85A / Isat 4A**，110mΩ | 1 |
| **Y1** | TAXM8M4RDBCCT2T | SMD3225-4P | `C400090` | 8MHz 无源，负载 10pF，±10ppm | 1 |

> **L1 选型依据**：RY8411 为 1.2A 输出，12V→5V 时电感纹波电流约 0.78A，
> **峰值电流约 1.59A**，故要求 Isat > 1.6A 并留余量。
> 已淘汰的候选：`C19398` SWPA3015（Isat 仅 1.4A，不够）、
> `C354574` CKCS4018（Isat 1.7A，余量仅 7%，太薄）。
>
> ⚠️ **Y1 必须选无源晶振**。检索结果里混有大量有源振荡器（SiT8008 / SG-8018CE 等），
> 不要误选 —— MCU 的 HSE 要无源。

---

## 3. 连接器

| 位号 | 型号 | 封装 | C 编号 | 用途 | 数量 |
|---|---|---|---|---|:---:|
| **J1** | XT30UPB-M | 插件通孔（公头板端） | `C428721` | 12V 电源输入（要求 1） | 1 |
| **J2 J3 J4** | WAFER-PH2.0-4PZZ | 插件 P=2mm 直插 | `C5359601` | 三路 UART（要求 3） | 3 |
| **J5** | WAFER-PH2.0-4PZZ | 插件 P=2mm 直插 | `C5359601` | I2C 第 3 路引出（要求 4） | 1 |
| **J6** | WAFER-PH2.0-6PZZ | 插件 P=2mm 直插 | `C5359603` | SPI-B 引出（要求 5） | 1 |
| **J7** | WAFER-PH2.0-3PZZ | 插件 P=2mm 直插 | `C5359600` | CAN：CANH / CANL / GND（要求 6） | 1 |
| **J8 J9 J10** | 2.54-1x6P 直针 | 插件 P=2.54mm | `C37208` | PWM 三排（要求 7） | 3 |
| **J11** | PZ2.54-2X5P-H25 | 插件 P=2.54mm | `C42431818` | SWD 调试口（要求 2） | 1 |
| **J12** | 2.54-2*8P 排针 | 插件 P=2.54mm | `C68234` | MCP23S17 的 16 路 GPIO 引出（要求 5） | 1 |

> **PH2.0 后缀含义**：`ZZ` = 直插（通孔立式）／`WZ` = 弯针／`WT` = SMD 卧贴／`LT` = SMD 立贴。
> 本板统一用 **ZZ 直插**款。

---

## 4. 机电元件

| 位号 | 型号 | 封装 | C 编号 | 用途 | 数量 |
|---|---|---|---|---|:---:|
| **SW1** | SS-12F44-G5 | 插件 SPDT 拨动开关 | `C136718` | 12V 输入总开关（要求 1） | 1 |
| **SW2 SW3** | TS-1187A-B-A-B | SMD-4P 5.1×5.1mm | `C318884` | RESET / BOOT 按键（要求 2） | 2 |

> ⚠️ 通孔 6×6 轻触开关 `C22546` **库存为 0**，不要用；统一用 SMD 的 TS-1187A 系列。

---

## 5. 指示灯

| 位号 | 型号 | 封装 | C 编号 | 颜色 | 用途 | 数量 |
|---|---|---|---|---|---|:---:|
| **LED1–LED3** | NCD0603G1 | 0603 | `C84267` | 绿 | 三路 GPIO LED（要求 9） | 3 |
| **LED4** | KT-0603R | 0603 | `C2286` | 红 | 12V 电源指示 | 1 |
| **LED5** | NCD0603G1 | 0603 | `C84267` | 绿 | 5V 电源指示 | 1 |
| **LED6** | NCD0603B1 | 0603 | `C84266` | 蓝 | 3.3V 电源指示 | 1 |

> 三颗电源灯分别用红/绿/蓝，一眼能分辨哪一路有电 —— 满足要求 1「带电源指示灯」。

---

## 6. 无源件（封装统一 0603，容值大者 0805）

| 类别 | 值 | C 编号 | 说明 |
|---|-----|---|---|
| 电阻 | 10kΩ | `C25804` | `0603WAF1002T5E`，嘉立创基础库 |
| 电阻 | 4.7kΩ | `C23162` | `0603WAF4701T5E` |
| 电阻 | 1kΩ | `C21190` | `0603WAF1001T5E` |
| 电阻 | 330Ω | `C23138` | `0603WAF3300T5E` |
| 电阻 | 100kΩ | `C25803` | `0603WAF1003T5E` |
| 电阻 | 19.1kΩ | `C22897` | `0603WAF1912T5E`，RY8411 反馈下分压 |
| 电阻 | 0Ω / 其它 | 同系列 `0603WAF****T5E` | 均为基础库 |
| 电容 | 100nF | `C14663` | `CC0603KRX7R9BB104`，基础库 |
| 电容 | 10nF | `C1589` | `CL10B103KB8NNNC`，VDDA 高频 |
| 电容 | 4.7µF | `C19666` | `CL10A475KO8NNNC` 0603 16V X5R |
| 电容 | 1µF | `C15849` | `CL10A105KB8NNNC` 0603 50V X5R |
| 电容 | 22µF | `C45783` | `CL21A226MAQNNNE` **0805** 25V X5R |
| 电容 | 12pF | `C107034` | `CC0603JRNPO9BN120` 0603 NP0，晶振负载 |
| 磁珠 | 600Ω@100MHz | `C19330` | `BLM18AG601SN1D` 0603 500mA，VDDA 隔离 |

> ⚠️ **磁珠选型踩过的坑**：最初选 `C1002`（GZ1608D601TF）与 `C1003`，
> 构建报成功，但 **FB1 一个焊盘都没有** —— EasyEDA 库里没有这两个元件的封装
> （`external_footprint_load_error`）。实测 `C1002`/`C1003` 失败，
> 而 `C19330` / `C20345` / `C73225` / `C14709` / `C50069` / `C12391` / `C62708` / `C35327`
> 全部可用。**选型后必须验证焊盘数。**

> ⚠️ **LED 极性不统一**：实测**红色 `C2286` 是 pin1=阳极**，
> 而**绿色 `C84267` / 蓝色 `C84266` 是 pin1=阴极**。
> 三颗都按同一约定写会导致绿/蓝两颗焊反。tscircuit 会用
> `source_component_misconfigured_error` 报出来（`scripts/check-modules.py` 已把它列为硬校验）。

> 大容量电容（22µF）在 0603 里耐压吃紧，已放到 **0805**（题目允许 0603 或 0805）。

---

## 7. 封装库验证（本 BOM 的核心结论）

### 验证方法

不是照文档抄，而是**把每种器件实际实例化一遍，强制解析封装，然后逐个数焊盘**：

```bash
cd ~/Desktop/tscircuit/my-tscircuit
export PATH="$HOME/Desktop/tscircuit/.tooling/bun/bin:$PATH"

# 1) 出图：任何封装解析失败都会在这里暴露
./tsci-run export circuits/stm32f302/_libcheck.tsx -f pcb-svg -o ../../out/stm32f302/_libcheck.svg

# 2) 出 circuit-json，逐器件数焊盘
./tsci-run export circuits/stm32f302/_libcheck.tsx -f circuit-json -o ../../out/stm32f302/_libcheck.json
```

### 验证结果

```
位号      型号/封装                       SMT    通孔    合计    应有  判定
====================================================================
U1      RY8411 SOT-23-6                 6     0     6     6  ✅
U2      TLV75733PDBVR SOT-23-5          5     0     5     5  ✅
U3      STM32F302R8T6 LQFP-64          64     0    64    64  ✅
U4      AT24C64D SOIC-8                 8     0     8     8  ✅
U5      TMP1075 VSSOP-8                 8     0     8     8  ✅
U6      MCP23S17 SSOP-28               28     0    28    28  ✅
U7      TCAN332 SOIC-8                  8     0     8     8  ✅
L1      4.7µH 4x4mm                     2     0     2     2  ✅
Y1      8MHz 3225                       4     0     4     4  ✅
J1      XT30 2P                         0     2     2     2  ✅
J2      PH2.0 1x4                      0     4     4     4  ✅
J6      PH2.0 1x6                      0     6     6     6  ✅
J7      PH2.0 1x3                      0     3     3     3  ✅
J8      1x6 2.54 排针                   0     6     6     6  ✅
J11     2x5 SWD                        0    10    10    10  ✅
J12     2x8 排针                        0    16    16    16  ✅
SW1     拨动开关                          0     5     5     5  ✅
SW2     轻触按键                          4     0     4     4  ✅
LED_G   0603 LED 绿                     2     0     2     2  ✅
LED_R   0603 LED 红                     2     0     2     2  ✅
LED_B   0603 LED 蓝                     2     0     2     2  ✅
R_10k   0603 电阻                       2     0     2     2  ✅
C_100n  0603 电容                       2     0     2     2  ✅
====================================================================
合计 SMT 焊盘 147 + 通孔 52 = 199
```

**解析耗时 17 秒，退出码 0，零报错。**

### 结论

| 问题 | 答案 |
|---|---|
| 库里有对应封装吗？ | ✅ **23 种全部都有** |
| 需要自己画库吗？ | ❌ **一个都不需要** |
| 焊盘数对得上引脚数吗？ | ✅ **23/23 全部匹配**（含 LQFP-64 的 64 脚） |

**封装来源**：`jlcpcb:Cxxxx` 直接拉取 EasyEDA 真实封装 —— 焊盘几何、丝印、位号
与嘉立创 SMT 下单时用的**完全一致**，不引入手抄误差。

> 附带收获：这批封装**通孔焊盘不会被生成锡膏开口**（SMT 焊盘 147、通孔 52 分开计数），
> 直接可用于制造层输出。

---

## 8. 待定项

| # | 待定内容 | 何时能定 |
|---|---|---|
| 1 | 无源件的具体阻容值 | 各模块电路设计时 |
| 2 | 无源件的数量（去耦电容个数等） | 同上 |
| 3 | 大容量电容是否需改用 0805 | 定值后按耐压/容值判断 |
| 4 | CAN 连接器最终用 1×3（CANH/CANL/GND）还是 1×2 | 现按 1×3，如需严格 2 线可改 `C5359599` |
| 5 | U3 是否备一份 RCT6 替代料的 BOM 行 | 交期紧张时 |

---

## 附：文件

| 文件 | 内容 |
|---|---|
| `circuits/stm32f302/_libcheck.tsx` | 封装自检电路（一次性工具，非成品） |
| `out/stm32f302/_libcheck.svg` / `.png` | 自检出图 |
| `out/stm32f302/_libcheck.json` | 自检 circuit-json（焊盘数来源） |
| `REQUIREMENTS.md` | 需求清单 |
| `PINMAP.md` / `pinmap.json` | 引脚分配表 |
