superfansizhe-beep/tscircuit-stm32f302-board/out/stm32f302/deliverables/05-3D/整板.step

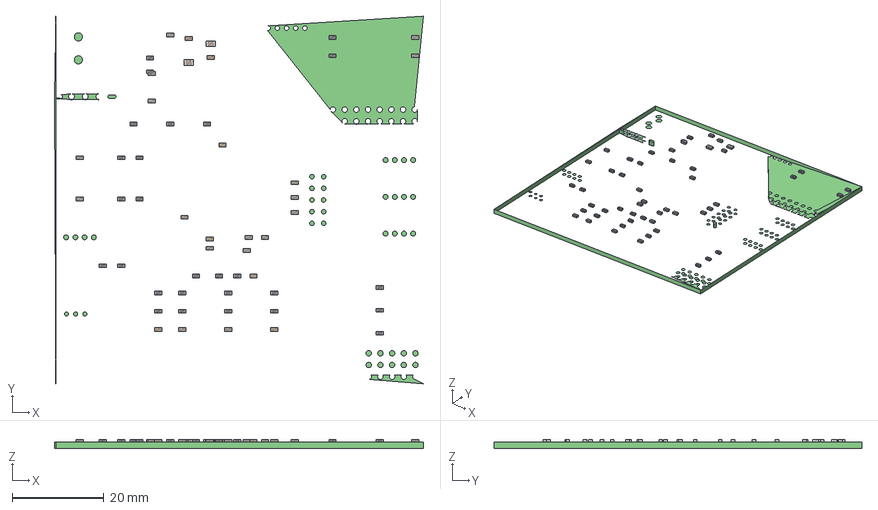
[picture p14: CAD file, 2026-10-12]
out/stm32f302/deliverables/05-3D/整板.step
80.3 x 80.0 x 2.00 mm
