superfansizhe-beep/tscircuit-stm32f302-board/out/stm32f302/deliverables/03-导入EasyEDA/main.kicad_pcb

## KiCad design out/stm32f302/deliverables/03-导入EasyEDA/main.kicad_pcb (2026-10-12)

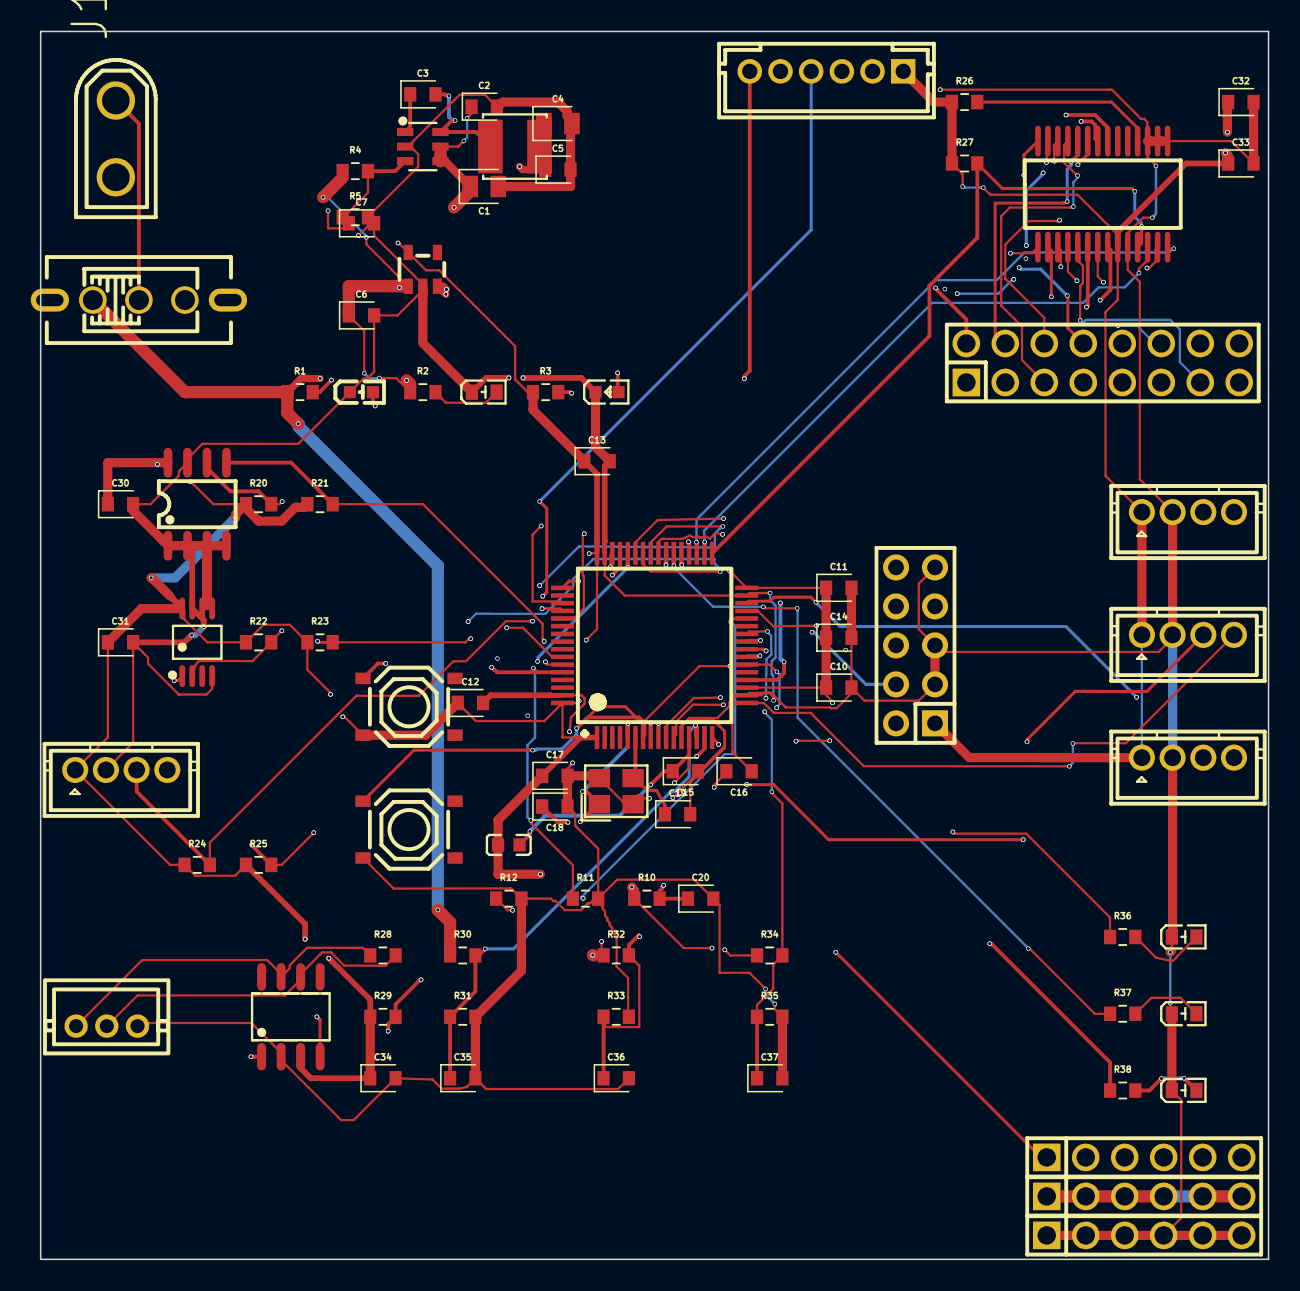
[picture p15: board main.kicad_pcb from above]

Board: 4 copper layers, 80.0 x 80.0 mm, 84 parts (0 on the bottom side), 75 nets.

Parts:
C1, C4: 22uF; CL21A226MAQNNNE
C2, C3, C5, C10, C11, C12, C13, C17, C20, C30, C31, C32, C33, C34, C35, C36, C37: 100nF; CC0603KRX7R9BB104
C6, C7, C15: 1uF; CL10A105KB8NNNC
C14: 4.7uF; CL10A475KO8NNNC
C16: 10nF; CL10B103KB8NNNC
C18, C19: 12pF; CC0603JRNPO9BN120
D1: KT-0603R
D2: NCD0603G1
D3: NCD0603B1
FB1: BLM18AG601SN1D
J1: J1; XT30UPB-M
J2: J2; WAFER-PH2_0-4PZZ
J3: J3; WAFER-PH2_0-4PZZ
J4: J4; WAFER-PH2_0-4PZZ
J5: J5; WAFER-PH2_0-4PZZ
J6: J6; WAFER-PH2_0-6PZZ
J7: J7; WAFER-PH2_0-3PZZ
J8: J8; 2_54-1x6P
J9: J9; 2_54-1x6P
J10: J10; 2_54-1x6P
J11: J11; PZ2_54-2X5P-H25
J12: J12; 2_54-2_8P
L1: 4.7µH; CKCSA4020-4_7uH_M
LED1, LED2, LED3: NCD0603G1
R1, R20, R21, R22, R23, R24, R25: 4.7kΩ; 0603WAF4701T5E
R2, R36, R37, R38: 1kΩ; 0603WAF1001T5E
R3: 330Ω; 0603WAF3300T5E
R4, R30, R32, R33: 100kΩ; 0603WAF1003T5E
R5: 19.1kΩ; 0603WAF1912T5E
R10, R11, R12, R26, R27, R29, R34: 10kΩ; 0603WAF1002T5E
R28: 120Ω; 0603WAF1200T5E
R31: 27kΩ; 0603WAF2702T5E
R35: 33kΩ; 0603WAF3302T5E
SW1: SS-12F44-G5
SW2, SW3: TS-1187A-B-A-B
U1: RY8411
U2: TLV75733PDBVR
U3: STM32F302R8T6
U4: AT24C64D-SSHM-T
U5: TMP1075DGKR
U6: MCP23S17T-E/SS; MCP23S17T-E_SS
U7: TCAN332DR
Y1: Y1; TAXM8M4RDBCCT2T

Connections:
ADC_3V3: C37.1, R34.2, R35.1, U3.26
ADC_5V: C36.1, R32.2, R33.1, U3.15
ADC_12V: C35.1, R30.2, R31.1, U3.14
BOOT0: R11.1, SW3.1, U3.60
CANH: J7.1, R28.1, U7.7
CANL: J7.2, R28.2, U7.6
CAN_RX: U3.44, U7.4
CAN_TX: R29.2, U3.45, U7.1
FB: R4.2, R5.1, U1.3
GND: C1.2, C2.2, C4.2, C5.2, C6.2, C7.2, C10.2, C11.2, C12.2, C13.2, C14.2, C15.2, C16.2, C17.2, C18.2, C19.2, C20.2, C30.2, C31.2, C32.2, C33.2, C34.2, C35.2, C36.2, C37.2, D1.2, D2.1, D3.1, J1.2, J2.2, J3.2, J4.2, J5.2, J6.2, J7.3, J10.1, J10.2, J10.3, J10.4, J10.5, J10.6, J11.3, J11.5, J11.9, LED1.1, LED2.1, LED3.1, R5.2, R11.2, R12.2, R31.2, R33.2, R35.2, SW2.3, U1.2, U2.2, U3.12, U3.18, U3.31, U3.47, U3.63, U4.1, U4.2, U4.3, U4.4, U4.7, U5.4, U5.5, U5.6, U5.7, U6.10, U6.15, U6.16, U6.17, U7.2, Y1.2, Y1.4
GPIO_LED1: R36.1, U3.37
GPIO_LED2: R37.1, U3.38
GPIO_LED3: R38.1, U3.39
HSE_IN: C18.1, U3.5, Y1.1
HSE_OUT: C19.1, U3.6, Y1.3
I2C1_SCL: R20.2, U3.58, U4.6
I2C1_SDA: R21.2, U3.59, U4.5
I2C2_SCL: R22.2, U3.42, U5.2
I2C2_SDA: R23.2, U3.43, U5.1
I2C3_SCL: J5.3, R24.2, U3.41
I2C3_SDA: J5.4, R25.2, U3.40
J1.VIN to SW1.COM: J1.1, SW1.2
MCP_RESET: R26.2, U6.18
NRST: C20.1, J11.10, R10.2, SW2.1, U3.7
PWM1: J8.1, U3.8
PWM2: J8.2, U3.9
PWM3: J8.3, U3.10
PWM4: J8.4, U3.11
PWM5: J8.5, U3.22
PWM6: J8.6, U3.23
R1.pin2 to D1.anode: D1.1, R1.2
R2.pin2 to D2.anode: D2.2, R2.2
R3.pin2 to D3.anode: D3.2, R3.2
R12.pin1 to U3.pin28: R12.1, U3.28
R36.pin2 to LED1.anode: LED1.2, R36.2
R37.pin2 to LED2.anode: LED2.2, R37.2
R38.pin2 to LED3.anode: LED3.2, R38.2
SPI2_CS: R27.2, U3.33, U6.11
SPI2_MISO: U3.35, U6.14
SPI2_MOSI: U3.36, U6.13
SPI2_SCK: U3.34, U6.12
SPI3_CS: J6.6, U3.20
SPI3_MISO: J6.4, U3.52
SPI3_MOSI: J6.5, U3.53
SPI3_SCK: J6.3, U3.51
SW: C3.2, L1.1, U1.6
SWCLK: J11.4, U3.49
SWDIO: J11.2, U3.46
U1.BS to C3.pin1: C3.1, U1.1
U6.GPA0 to J12.pin1: J12.1, U6.21
U6.GPA1 to J12.pin2: J12.2, U6.22
U6.GPA2 to J12.pin3: J12.3, U6.23
U6.GPA3 to J12.pin4: J12.4, U6.24
U6.GPA4 to J12.pin5: J12.5, U6.25
U6.GPA5 to J12.pin6: J12.6, U6.26
U6.GPA6 to J12.pin7: J12.7, U6.27
U6.GPA7 to J12.pin8: J12.8, U6.28
U6.GPB0 to J12.pin9: J12.9, U6.1
U6.GPB1 to J12.pin10: J12.10, U6.2
U6.GPB2 to J12.pin11: J12.11, U6.3
U6.GPB3 to J12.pin12: J12.12, U6.4
U6.GPB4 to J12.pin13: J12.13, U6.5
U6.GPB5 to J12.pin14: J12.14, U6.6
U6.GPB6 to J12.pin15: J12.15, U6.7
U6.GPB7 to J12.pin16: J12.16, U6.8
UART1_RX: J2.4, U3.25
UART1_TX: J2.3, U3.24
UART2_RX: J3.4, U3.17
UART2_TX: J3.3, U3.16
UART3_RX: J4.4, U3.30
UART3_TX: J4.3, U3.29
V3_3: C7.1, C10.1, C11.1, C12.1, C13.1, C14.1, C17.1, C30.1, C31.1, C32.1, C33.1, C34.1, FB1.1, J2.1, J3.1, J4.1, J5.1, J6.1, J11.1, R3.1, R10.1, R20.1, R21.1, R22.1, R23.1, R24.1, R25.1, R26.1, R27.1, R29.1, R34.1, SW3.3, U2.5, U3.1, U3.19, U3.32, U3.48, U3.64, U4.8, U5.8, U6.9, U7.3
V5: C4.1, C5.1, C6.1, J9.1, J9.2, J9.3, J9.4, J9.5, J9.6, L1.2, R2.1, R4.1, R32.1, U2.1, U2.3
V12: C1.1, C2.1, R1.1, R30.1, SW1.1, U1.4, U1.5
VDDA: C15.1, C16.1, FB1.2, U3.13
